TheKastenkarl/micromouse/pcb/micromouse/micromouse.brd

## EAGLE design pcb/micromouse/micromouse.brd (2022-07-06)

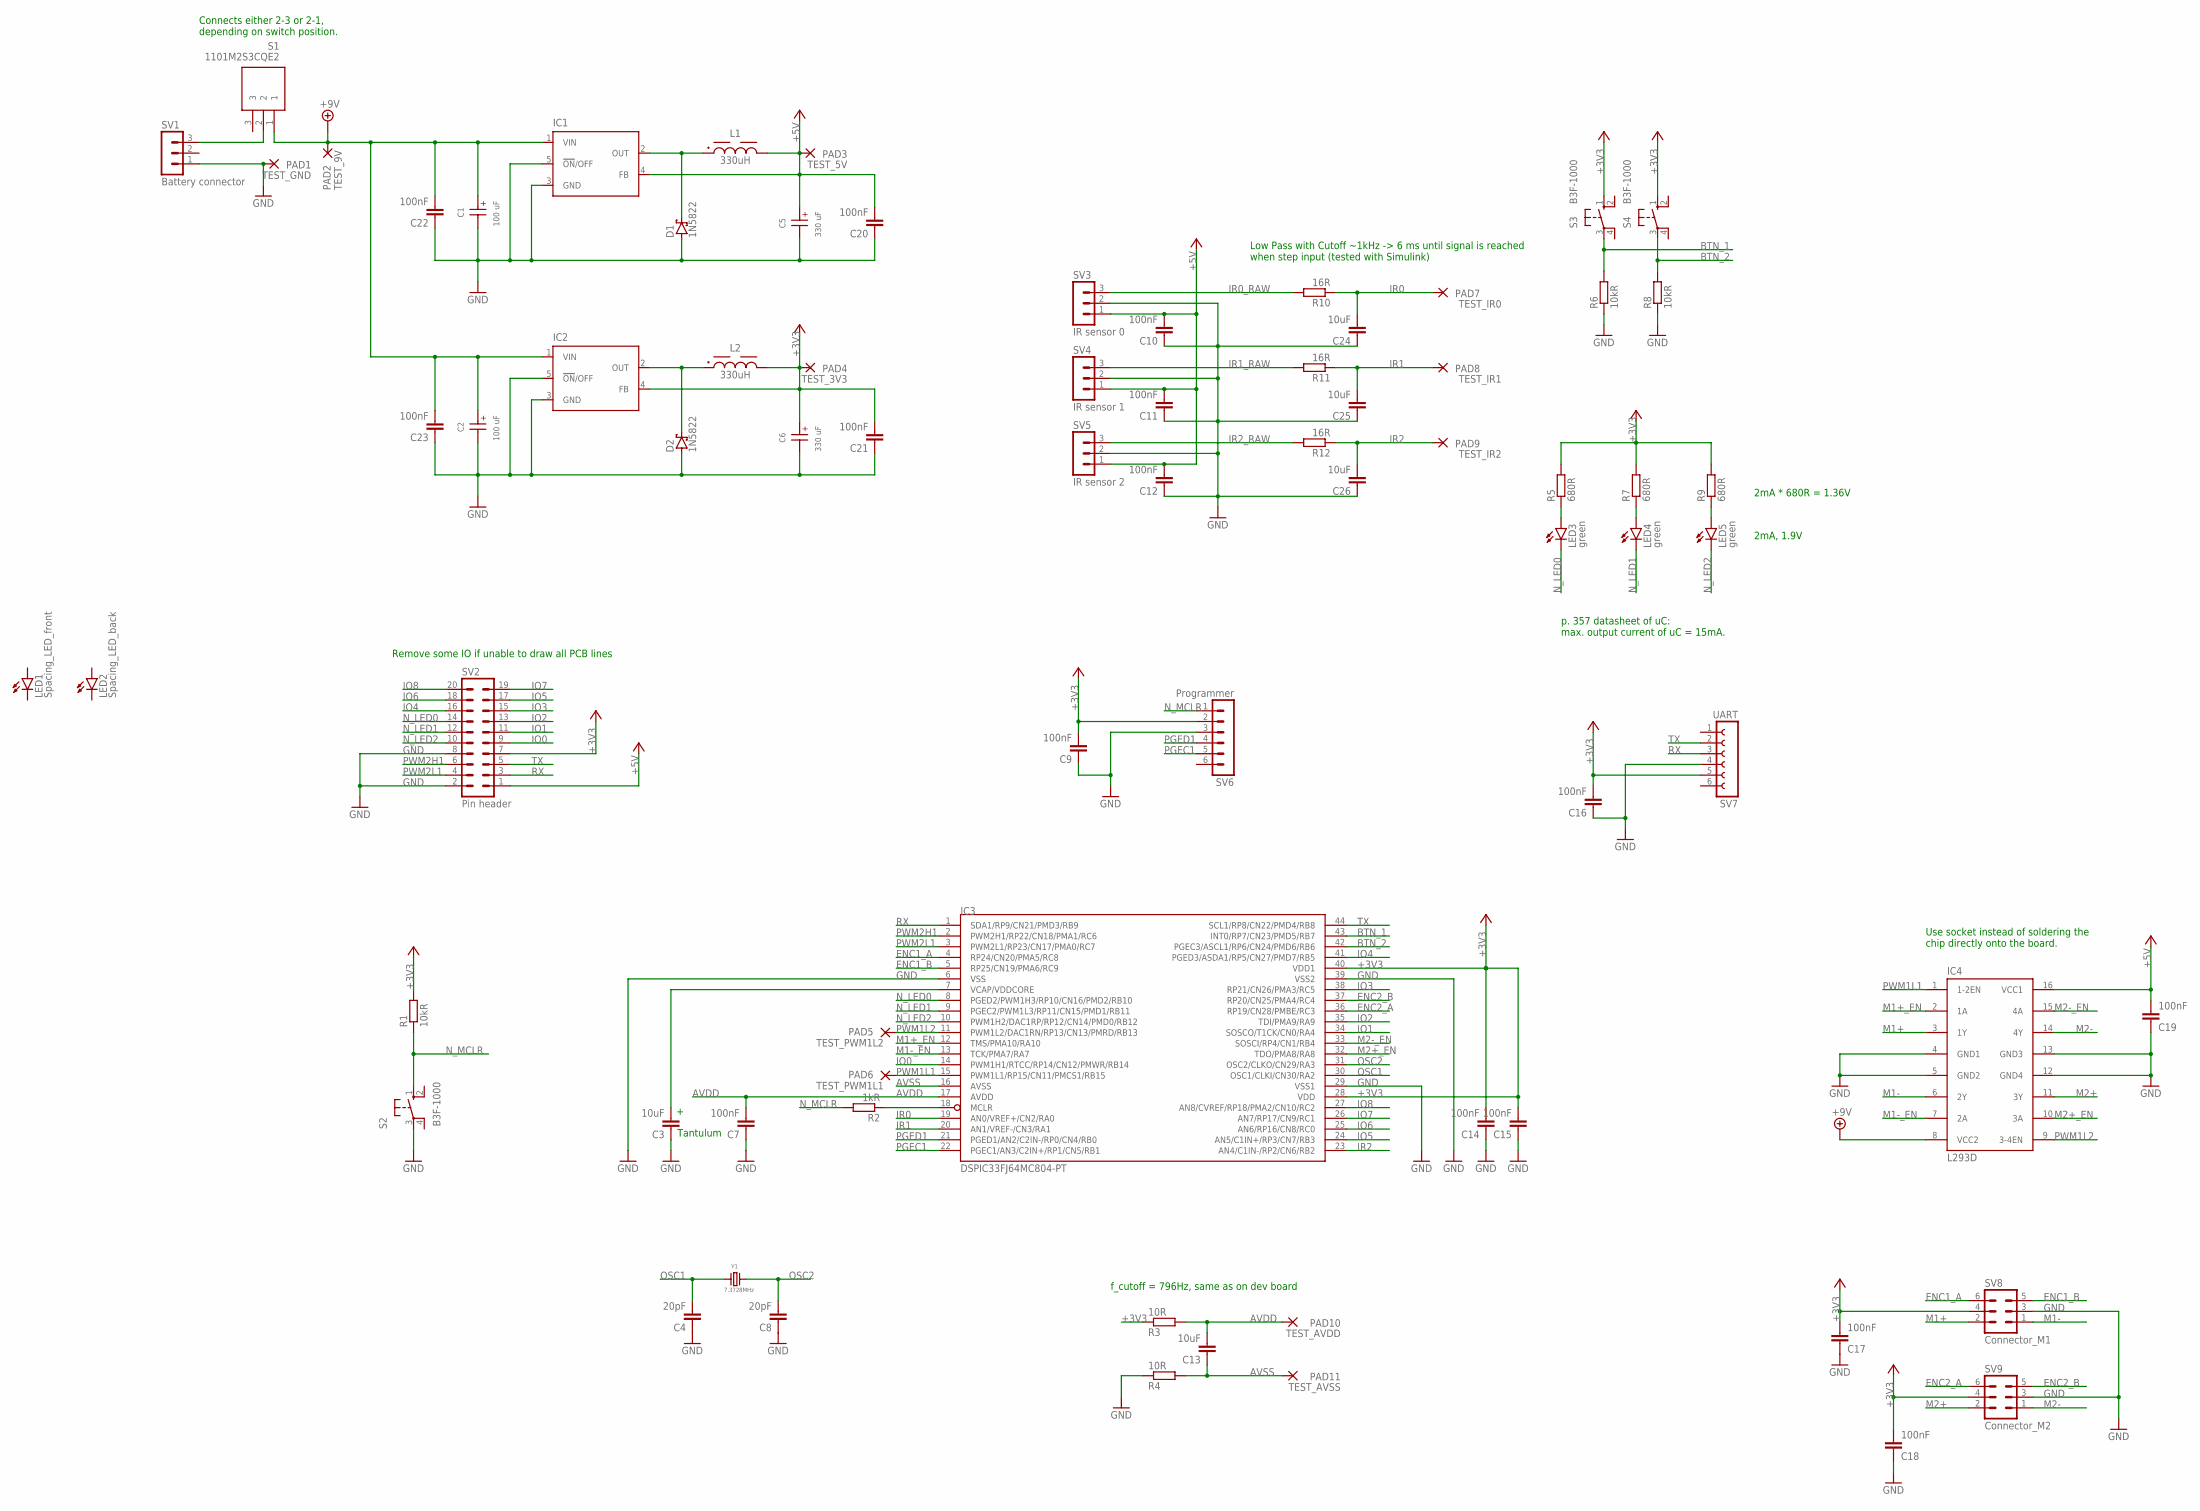
[picture p4: schematic micromouse.sch]

Parts:
C1, C2: 100 uF; WCAP-ATG5_5X11(DXL)
C3, C13, C24, C25, C26: 10uF; C0805
C4, C8: 20pF; C0805
C5, C6: 330 uF; WCAP-ATG5_6.3X11(DXL)
C7, C9, C10, C11, C12, C14, C15, C16, C17, C18, C19, C20, C21, C22, C23: 100nF; C0805
D1, D2: 1N5822; DO35-10
IC1: LM2575-5.0WU-(TR); TO263-5
IC2: LM2575-3.3WU-(TR); TO263-5
IC3: DSPIC33FJ64MC804-PT; TQFP44
IC4: L293D; DIL16
L1, L2: 330uH; WE-TIS_1111
LED1: Spacing_LED_front; LED5MM
LED2: Spacing_LED_back; LED5MM
LED3, LED4, LED5: green; CHIP-LED0805
PAD1: TEST_GND; 3,17/1,3
PAD2: TEST_9V; 3,17/1,3
PAD3: TEST_5V; 3,17/1,3
PAD4: TEST_3V3; 3,17/1,3
PAD5: TEST_PWM1L2; 3,17/1,3
PAD6: TEST_PWM1L1; 3,17/1,3
PAD7: TEST_IR0; 3,17/1,3
PAD8: TEST_IR1; 3,17/1,3
PAD9: TEST_IR2; 3,17/1,3
PAD10: TEST_AVDD; 3,17/1,3
PAD11: TEST_AVSS; 3,17/1,3
R1, R6, R8: 10kR; R0805
R2: 1kR; R0805
R3, R4: 10R; R0805
R5, R7, R9: 680R; R0805
R10, R11, R12: 16R; R0805
S1: 1101M2S3CQE2; 1000-SERIES(SPDT)
S2, S3, S4: B3F-1000; B3F-10XX
SV1: Battery connector; MA03-1
SV2: Pin header; MA10-2
SV3: IR sensor 0; MA03-1
SV4: IR sensor 1; MA03-1
SV5: IR sensor 2; MA03-1
SV6: Programmer; MA06-1
SV7: UART; FE06
SV8: Connector_M1; ML6
SV9: Connector_M2; ML6
Y1: 7.3728MHz; WE-XTAL_HC49/4H

Connections:
+3V3: C6.1 (+), C9.2, C14.2, C15.2, C16.2, C17.2, C18.2, C21.2, IC2.4 (FB), IC3.28 (VDD), IC3.40 (VDD1), L2.2, PAD4.1, R1.2, R3.1, R5.2, R7.2, R9.2, S3.1 (S), S4.1 (S), SV2.7, SV6.2, SV7.5, SV8.4, SV9.4
+5V: C5.1 (+), C10.2, C11.2, C12.2, C19.2, C20.2, IC1.4 (FB), IC4.16 (VCC1), L1.2, PAD3.1, SV2.1, SV3.1, SV4.1, SV5.1
+9V: C1.1 (+), C2.1 (+), C22.2, C23.2, IC1.1 (VIN), IC2.1 (VIN), IC4.8 (VCC2), PAD2.1, S1.1
AVDD: C7.2, C13.2, IC3.17 (AVDD), PAD10.1, R3.2
AVSS: C13.1, IC3.16 (AVSS), PAD11.1, R4.2
BTN_1: IC3.43 (INT0/RP7/CN23/PMD5/RB7), R6.2, S3.3
BTN_2: IC3.42 (PGEC3/ASCL1/RP6/CN24/PMD6/RB6), R8.2, S4.3
ENC1_A: IC3.4 (RP24/CN20/PMA5/RC8), SV8.6
ENC1_B: IC3.5 (RP25/CN19/PMA6/RC9), SV8.5
ENC2_A: IC3.36 (RP19/CN28/PMBE/RC3), SV9.6
ENC2_B: IC3.37 (RP20/CN25/PMA4/RC4), SV9.5
GND: C1.2 (-), C2.2 (-), C3.1, C4.1, C5.2 (-), C6.2 (-), C7.1, C8.1, C9.1, C10.1, C11.1, C12.1, C14.1, C15.1, C16.1, C17.1, C18.1, C19.1, C20.1, C21.1, C22.1, C23.1, C24.1, C25.1, C26.1, D1.A, D2.A, IC1.3 (GND), IC1.5 (!ON!/OFF), IC2.3 (GND), IC2.5 (!ON!/OFF), IC3.6 (VSS), IC3.29 (VSS1), IC3.39 (VSS2), IC4.4 (GND1), IC4.5 (GND2), IC4.12 (GND4), IC4.13 (GND3), PAD1.1, R4.1, R6.1, R8.1, S2.3, SV1.1, SV2.2, SV2.8, SV3.2, SV4.2, SV5.2, SV6.3, SV7.4, SV8.3, SV9.3
IO0: IC3.14 (PWM1H1/RTCC/RP14/CN12/PMWR/RB14), SV2.9
IO1: IC3.34 (SOSCO/T1CK/CN0/RA4), SV2.11
IO2: IC3.35 (TDI/PMA9/RA9), SV2.13
IO3: IC3.38 (RP21/CN26/PMA3/RC5), SV2.15
IO4: IC3.41 (PGED3/ASDA1/RP5/CN27/PMD7/RB5), SV2.16
IO5: IC3.24 (AN5/C1IN+/RP3/CN7/RB3), SV2.17
IO6: IC3.25 (AN6/RP16/CN8/RC0), SV2.18
IO7: IC3.26 (AN7/RP17/CN9/RC1), SV2.19
IO8: IC3.27 (AN8/CVREF/RP18/PMA2/CN10/RC2), SV2.20
IR0: C24.2, IC3.19 (AN0/VREF+/CN2/RA0), PAD7.1, R10.1
IR0_RAW: R10.2, SV3.3
IR1: C25.2, IC3.20 (AN1/VREF-/CN3/RA1), PAD8.1, R11.1
IR1_RAW: R11.2, SV4.3
IR2: C26.2, IC3.23 (AN4/C1IN-/RP2/CN6/RB2), PAD9.1, R12.1
IR2_RAW: R12.2, SV5.3
M1+: IC4.3 (1Y), SV8.2
M1+_EN: IC3.12 (TMS/PMA10/RA10), IC4.2 (1A)
M1-: IC4.6 (2Y), SV8.1
M1-_EN: IC3.13 (TCK/PMA7/RA7), IC4.7 (2A)
M2+: IC4.11 (3Y), SV9.2
M2+_EN: IC3.32 (TDO/PMA8/RA8), IC4.10 (3A)
M2-: IC4.14 (4Y), SV9.1
M2-_EN: IC3.33 (SOSCI/RP4/CN1/RB4), IC4.15 (4A)
unnamed: IC3.18 (MCLR), R2.1
unnamed: S1.2, SV1.3
unnamed: LED3.A, R5.1
unnamed: LED4.A, R7.1
unnamed: LED5.A, R9.1
unnamed: D1.C, IC1.2 (OUT), L1.1
unnamed: D2.C, IC2.2 (OUT), L2.1
N_LED0: IC3.8 (PGED2/PWM1H3/RP10/CN16/PMD2/RB10), LED3.C, SV2.14
N_LED1: IC3.9 (PGEC2/PWM1L3/RP11/CN15/PMD1/RB11), LED4.C, SV2.12
N_LED2: IC3.10 (PWM1H2/DAC1RP/RP12/CN14/PMD0/RB12), LED5.C, SV2.10
N_MCLR: R1.1, R2.2, S2.1 (S), SV6.1
OSC1: C4.2, IC3.30 (OSC1/CLKI/CN30/RA2), Y1.1
OSC2: C8.2, IC3.31 (OSC2/CLKO/CN29/RA3), Y1.2
PGEC1: IC3.22 (PGEC1/AN3/C2IN+/RP1/CN5/RB1), SV6.5
PGED1: IC3.21 (PGED1/AN2/C2IN-/RP0/CN4/RB0), SV6.4
PWM1L1: IC3.15 (PWM1L1/RP15/CN11/PMCS1/RB15), IC4.1 (1-2EN), PAD6.1
PWM1L2: IC3.11 (PWM1L2/DAC1RN/RP13/CN13/PMRD/RB13), IC4.9 (3-4EN), PAD5.1
PWM2H1: IC3.2 (PWM2H1/RP22/CN18/PMA1/RC6), SV2.6
PWM2L1: IC3.3 (PWM2L1/RP23/CN17/PMA0/RC7), SV2.4
RX: IC3.1 (SDA1/RP9/CN21/PMD3/RB9), SV2.3, SV7.3
TX: IC3.44 (SCL1/RP8/CN22/PMD4/RB8), SV2.5, SV7.2
VCAP/VDDCORE: C3.2, IC3.7 (VCAP/VDDCORE)

Notes on the sheet:
p. 357 datasheet of uC: max. output current of uC = 15mA.
2mA, 1.9V
2mA * 680R = 1.36V
Use socket instead of soldering the chip directly onto the board.
f_cutoff = 796Hz, same as on dev board
Connects either 2-3 or 2-1, depending on switch position.
Remove some IO if unable to draw all PCB lines
Tantulum
Low Pass with Cutoff ~1kHz -> 6 ms until signal is reached when step input (tested with Simulink)

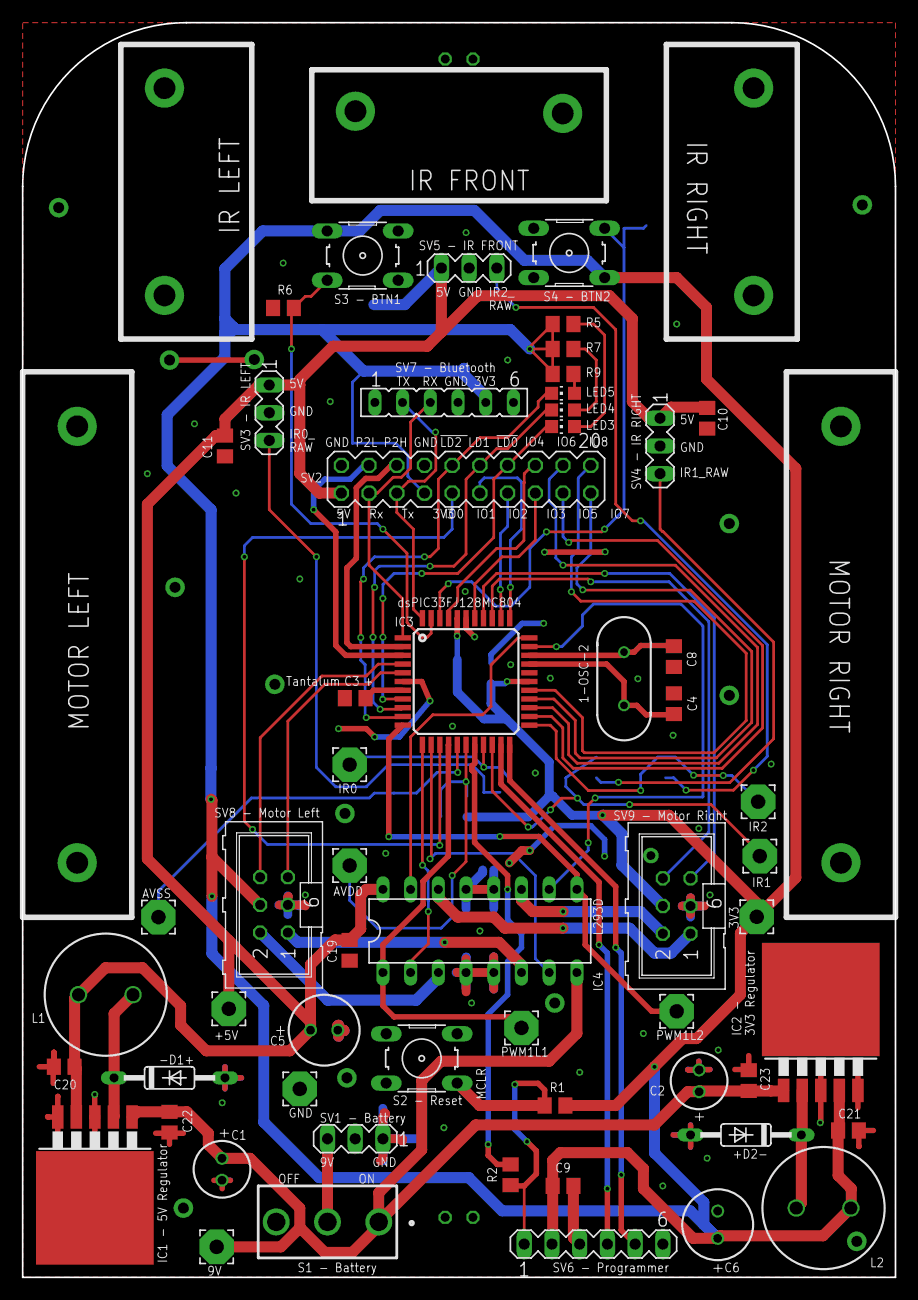
[picture p5: board micromouse.brd from above]

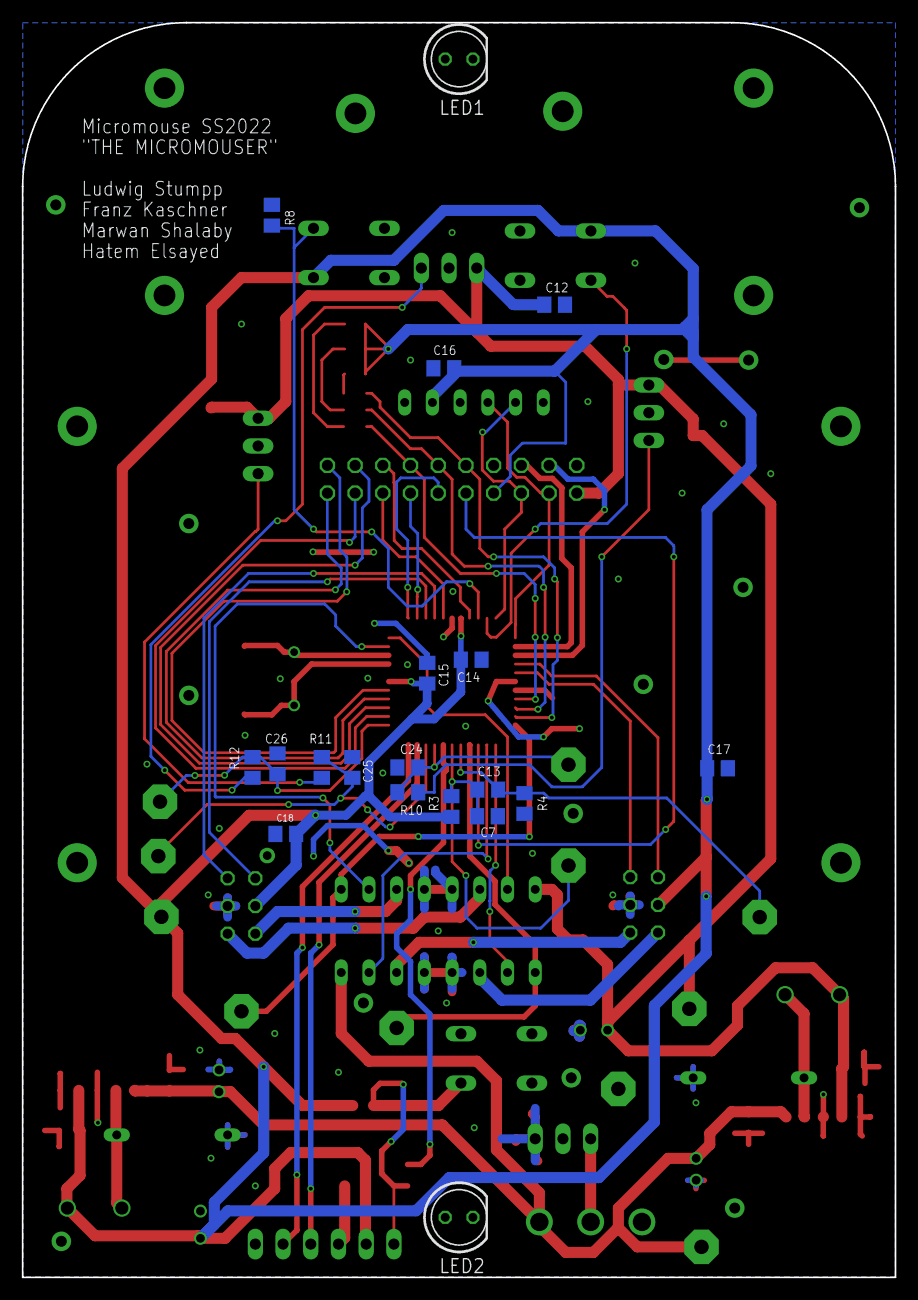
[picture p6: board micromouse.brd from below]

Board: 2 copper layers, 80.0 x 115.0 mm, 76 parts (19 on the bottom side), 57 nets.
