TheKastenkarl/micromouse/src/robot.h

#ifndef ROBOT_H
#define	ROBOT_H

// Positions (= cell ids) are described with numbers from 0 to MAZE_SIZE * MAZE_SIZE
// Example: cell in third row, fourth column -> cell id = (3 - 1) * MAZE_SIZE + (4 - 1)
typedef struct Robot {
    int position;
    int orientation;
} Robot;

enum Direction {
    LEFT = 0,
    FRONT = 1,
    RIGHT = 2,
    BACK = 3
};

enum Orientation {
    WEST = 0b0001,
    NORTH = 0b0010,
    EAST = 0b0100,
    SOUTH = 0b1000
};

void init_robot(Robot* robot, const int initial_position, const int initial_orientation);

int is_wall_front();
int is_wall_right();
int is_wall_left();

int no_wall_west(Robot* const robot);
int no_wall_north(Robot* const robot);
int no_wall_east(Robot* const robot);
int no_wall_south(Robot* const robot);

void move_forward(Robot* robot, const int distance);

// spin at current position by -90°
void turn_right(Robot* robot);

// spin at current position by +90°
void turn_left(Robot* robot);

// turn the robot such that it has the given orientation
void turn_to_orientation(Robot* robot, const int orientation);

#endif /* ROBOT_H */
