TheKastenkarl/micromouse/src/main_maze_solver.c

#include "API.h"
#include "maze_solver.h"
#include "wall_follow.h"

#if SIMULATION
int main_maze_solver(int argc, char* argv[]) {
    explore_and_exploit();
    //wall_follow();
    return 0;
}
#endif
