TheKastenkarl/micromouse/src/queue.c

#include <stdio.h>
#include <stdlib.h>
#include "queue.h"

// Source: https://gist.github.com/kroggen/5fc7380d30615b2e70fcf9c7b69997b6

void enqueue(node_t** head, int val) {
    node_t* new_node = malloc(sizeof(node_t));
    if (!new_node) return;

    new_node->val = val;
    new_node->next = *head;

    *head = new_node;
}

int dequeue(node_t** head) {
    node_t* current = NULL;
    node_t* prev = NULL;
    int retval = -1;

    if (*head == NULL) return -1;

    current = *head;
    while (current->next != NULL) {
        prev = current;
        current = current->next;
    }

    retval = current->val;
    free(current);
    
    if (prev) {
        prev->next = NULL;
    } else {
        *head = NULL;
    }
    return retval;
}

void print_list(node_t* head) {
    node_t* current = head;

    while (current != NULL) {
        printf("%d\n", current->val);
        current = current->next;
    }
}

/* EXAMPLE CODE:
node_t *head = NULL;
int ret;

enqueue(&head, 11);
enqueue(&head, 22);
enqueue(&head, 33);
enqueue(&head, 44);

print_list(head);
    
while ((ret=dequeue(&head)) > 0) {
    printf("dequeued %d\n", ret);
}
printf("done. head=%p\n", head);

return 0;
*/
