TheKastenkarl/micromouse/src/utils.c

#include "xc.h"
#include "utils.h"

// Utility module
//
// mainly for helper functions.

/**
 * Converts a value proportionally between ranges.
 * 
 * @param aMin: minimum value of range A
 * @param aMax: maximum value of range A 
 * @param bMin: minimum value of range B
 * @param bMax: maximum value of range B
 * @param aVal: input value in range A
 * @return: corresponding value in range B
 */
float convertRanges(float aMin, float aMax, float bMin, float bMax, float aVal) {
    float temp, bVal;
    // 1. [aMin, aMax] -> [0, aMax - aMin]
    temp = aVal - aMin;
    // 2. [0, aMax - aMin] -> [0, bMax - bMin]
    temp = temp * (bMax - bMin) / (aMax - aMin);
    // 3. [0, bMax - bMin] -> [bMin, bMax]
    bVal = temp + bMin;

    return bVal;
}

/**
 * Calculates the smallest possible prescaler value for timer applications.
 * 
 * Writes back results to passed adresses for "positionIndex" and "reqCount"
 * 
 * @param periodMsDesired: Desired timer period in miliseconds
 * @param timerMaxCount: Maximum count value of timer
 * @param internalTimeBaseUs: Internal cycle time in mikroseconds
 * @param prescaleValues[]: array of available prescale values, assumed to be
 *      in ascending order, e.g [1, 4, 16, 64]
 * @param len: len of "prescaleValues" array
 * @param positionIndex: calculated index in "prescaleValues" to choose
 * @param reqCount: calculated required count to achieve desired period
 */
void getPositionSmallestPossiblePrescaler(
        float periodMsDesired,
        float timerMaxCount,
        float internalTimeBaseUs,
        unsigned int prescaleValues[],
        unsigned char len,
        int* positionIndex,
        int* reqCount) {

    // calculate by which factor our required counting value is too high
    float timeOnePeriodMs = timerMaxCount / 1000 * internalTimeBaseUs; // swapping division by 1000 to front to not have overflow
    float fractionCountPossible = periodMsDesired / timeOnePeriodMs; // 

    // return error if not possible
    if (fractionCountPossible > prescaleValues[len - 1]) {
        *positionIndex = -1;
    }

    // otherwise choose lowest prescale value
    unsigned char i = 0;
    for (i = 0; i < len; i++) {
        if (fractionCountPossible < prescaleValues[i]) {
            *positionIndex = i;
            break;
        }
    }

    int prescaleValue = prescaleValues[i];
    *reqCount = (int) (timerMaxCount / prescaleValue * fractionCountPossible);
}

/**
 * Calculates an exponential moving average of the form:
 * 
 * v_k = (1 - updateFrac) * oldVal + updateFrac * newVal
 * 
 * @param oldVal: Old value at the last timestep.
 * @param newVal: New value at current timestep before filtering.
 * @param updateFrac: Fraction that tells how much to consider the new value.
 * @return Value at current timestep after filtering.
 */
float expMovingAvg(float oldVal, float newVal, float updateFrac) {
    return (1. - updateFrac) * oldVal + updateFrac * newVal;
}
