TheKastenkarl/micromouse/(commit log)

2022-06-13 Started eagle sketch
    [micromouse.sch]
2022-06-14 Add distance sensors, LEDs and prepared supply
    [micromouse.sch]
2022-06-15 Schematic: Replace RCL components with european versions, add oscillator and add parts of H bridge.
    [micromouse.sch]
2022-06-16 Replaced reset switch, added voltage regulators
    [micromouse.sch]
2022-06-18 Add motor connectors, complete h bridge, add UART pins, add pin header for debugging, change series resistors of LEDs.
    [micromouse.sch]
2022-06-18 Additional buttons, draft of LED transistor, power switch, few corrections and additional questions
    [micromouse.brd, micromouse.sch]
2022-06-18 Fix hluetooth module supply voltage to 3.3V
    [micromouse.brd, micromouse.sch]
2022-06-19 Started with hardware parts alignment, add battery holes connection, additional comments
    [micromouse.brd, micromouse.sch]
2022-06-19 Add comment regarding connector for distance sensors
    [micromouse.sch]
2022-06-19 Add correct switch, change connection of LEDs, connect signals from hbridge and motor with uC, fix connection of programmer, add signals to debugging pin header, add front wheel LED, connect capacito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
    [micromouse.brd, micromouse.sch]
2022-06-19 Fixed connections of power switch and implemented inductors for voltage regulators
    [micromouse.brd, micromouse.sch]
2022-06-20 Add missing junction (two wires were not correctly connected).
    [micromouse.brd, micromouse.sch]
2022-06-21 Fix connection of IR sensors
    [micromouse.brd, micromouse.sch]
2022-06-21 Additional comment to have coupling capacitor at h bridge
    [micromouse.sch]
2022-06-21 Additional comment regarding helper header
    [micromouse.sch]
2022-06-22 initial putting components in place
    [micromouse.brd, micromouse.sch]
2022-06-22 width: 81mm, height: 99mm curves on front edges All connections done except for ground Not all notes were looked through
    [micromouse.brd]
2022-06-24 Exchanged 100 uF capacitors at voltage regulator to have 1210 mounting layout + added ground planes
    [micromouse.brd, micromouse.sch]
2022-06-24 Fix positioning of power switch.
    [micromouse.brd, micromouse.sch]
2022-06-24 Remove resolved comments and only use resistors fom E12 series.
    [micromouse.brd, micromouse.sch]
2022-06-24 Use pin header as battery connector and change reset botton setup.
    [micromouse.brd, micromouse.sch]
2022-06-25 Removed comment at battery connector. We will use a male one on the board
    [micromouse.sch]
2022-06-25 Exchanged capacitors and inductances in power supply
    [micromouse.brd, micromouse.sch]
2022-06-25 Add test points
    [micromouse.brd, micromouse.sch]
2022-06-26 Increase width of lanes, all 45 degree angles errors resolved design rules obeyed
    [micromouse.brd, micromouse.sch]
2022-06-26 Dimentions corrected
    [micromouse.brd]
2022-06-26 Holes + Labels
    [micromouse.brd]
2022-06-26 TO DO notes checked, components not colliding
    [micromouse.brd]
2022-06-26 Made names more readable
    [micromouse.brd]
2022-06-26 Renamed parts in ascending order
    [micromouse.brd, micromouse.sch]
2022-06-27 Change comment next to series resistors of LEDs (voltage was wrong)
    [micromouse.sch]
2022-06-28 Wired capacitors, fixed one missing stub error
    [micromouse.brd, micromouse.sch]
2022-06-28 Fixed dimensions, mounting, gnd plate
    [micromouse.brd]
2022-06-28 Fix position of holes for mounts and correct naming of components in silk layer.
    [micromouse.brd]
2022-06-29 Fix positioning of motor connectors.
    [micromouse.brd]
2022-06-29 Fixed ground plate isolation distance, mounting holes and errors
    [micromouse.brd, micromouse.sch]
2022-06-29 Almost final steps of PCB, before moving the oscillator
    [micromouse.brd, micromouse.sch]
2022-06-29 Intermediate state of moving of oscillator
    [micromouse.brd]
2022-06-29 Finished wiring of oscialltor, few minor improvements and added missing silk labels
    [micromouse.brd, micromouse.sch]
2022-06-30 Add group name, move via next to oscillator and replace LEDs with low current LEDs.
    [micromouse.brd, micromouse.sch]
2022-06-30 vias+beef gnds
    [micromouse.brd]
2022-06-30 pcb remarks solve 3V3 branch other side no vias for 9v to H bridge beef gnd pins delete t/b Names make AVDD+AVSS closer better path under uc vias near oscilator, controller and controller voltage reg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
    [micromouse.brd]
2022-07-01 Change position of silk writings.
    [micromouse.brd]
2022-07-03 Add 100nF capacitors at inputs and outputs of both switching converters. Add vias for ground stitching.
    [micromouse.brd, micromouse.sch]
2022-07-04 Fix minor issues from previous commit.
    [micromouse.brd]
2022-07-05 Move 100nF capacitors of switching converters close to the input/output of the converters. Connect stitching vias to GND. Activate ground plane (ratsnest).
    [micromouse.brd]
2022-07-05 Improved connection out of 5V regulator in star connection + added one ground via
    [micromouse.brd]
2022-07-06 Added low pass filter for distance sensors
    [micromouse.brd, micromouse.sch]
2022-07-06 Remove extra GND connections or make them smaller. Remove typos. Make enough space for bluetooth module (9mm).
    [micromouse.brd]
2022-07-06 Move front IR sensor more to the center and fixthe positioning of silk writing.
    [micromouse.brd]
2022-07-06 Fix positioning of silk writing.
    [micromouse.brd]
2022-07-06 Fixed one ground line and one silk name
    [micromouse.brd]
2022-07-06 Move 3V3 signal more to the right away from programmer
    [micromouse.brd]
2022-07-12 Adapted serial communication code + resolved few errors such that now buildable
    [main.c, serialComms.c, serialComms.h, timer.h]
2022-07-12 Simplified ADC scan setup by inverting the analogue pin setup from the IOConfig
    [adc.c, main.c]
2022-07-12 Added motor functions
2022-07-12 Updates on Constants for motor encoder
2022-07-12 Add function to measure motor rotation in rotations per sample + add to measurement for tomorrow
2022-07-13 Add config for development board test setup
2022-07-13 Fixed encoder test
    Issue was that we were calculating the velocity every 100 ms while we need it every second
    [tests.c, timer.c]
2022-07-14 Simplified the encoder interface by combining the update of absolute and delta counts
2022-07-15 Fixed a few bugs
    [main.c, motorEncoders.c, motors.c, serialComms.c, serialComms.h, tests.c, tests.h]
2022-08-07 Add function to test buttons and leds
2022-08-08 Few fixes + first working version on our mouse
    [IOconfigDevBoard.c, IOconfigDevBoard.h, adc.c, dma.c, main.c, motorEncoders.c, motors.c, pwm.c]
2022-08-11 Improved motor test
2022-08-23 Added exp. moving average filter for IR values
2022-08-25 Removed pcb library that was not in use
2022-09-19 Fix high-level path planner (move_to_cell did not work correctly when starting at cell 0)
    [maze_solver.c]
2022-09-23 remove tests in timer.c
2022-09-23 Add UART outputs to high-level maze solver.
2022-09-23 Add UART outputs to high-level maze solver, part 2.
2022-09-23 Add delay to main function to have time to connect UART.
2022-09-23 Add UART outputs to high-level maze solver, part 3. Increase distance of move forward.
2022-09-23 Add UART outputs to high-level maze solver, part 4.
2022-09-23 Remove most of the UART outputs and add function to output wall positions of stored maze via UART.
2022-09-23 Remove most of the UART outputs and add function to output wall positions of stored maze via UART, part 2.
