TheKastenkarl/micromouse/(notices)

Notices in the files:
parts and their libraries:
Eagle_WE-XTAL: Copyright: Würth Elektronik
